mindlogger/WaveformMorpher/README.md

# WaveformMorpher
Morphing wavetable Synthesizer based on a Raspberry Pi.
Dependencies:
>= Portaudio v190600_20161030
https://github.com/grz0zrg/fbg
https://github.com/nlohmann/json
http://www.fftw.org/
https://github.com/thestk/rtmidi
