mindlogger/WaveformMorpher/hardware_design/WaveformMorpher_partlist.xlsx

Waveform Morpher v0.7
Qty | Parts | Value | Package | Device | Description | DESCRIPTION.1 | HEIGHT | MANUFACTURER_NAME | MANUFACTURER_PART_NUMBER | MF | MOUSER_PART_NUMBER | MOUSER_PRICE-STOCK | MPN | OC_FARNELL | OC_NEWARK | PROD_ID | RS_PART_NUMBER | RS_PRICE-STOCK | SF_SKU | Column1
3 | R8, R9, R26 | 1.0k | R0603 | R-US_R0603 | RESISTOR, American symbol
7 | R10, R12, R14, R17, R19, R21, R23 | 100k | R0603 | R-US_R0603 | RESISTOR, American symbol
5 | C1, C8, C10, C11, C12 | 100n | C0603 | C-USC0603 | CAPACITOR, American symbol
8 | R1, R2, R3, R4, R5, R6, R7, R11 | 10k | R0603 | R-US_R0603 | RESISTOR, American symbol
6 | P1, P2, P3, P4, P5, P6 | 10kB | 9MM_SNAP-IN_POT | 9MM_SNAP-IN_POT_ | 9mm vertical snap-in pot, Alpha / Panasonic style
1 | C5 | 10u | PANASONIC_B | CPOL-USB | POLARIZED CAPACITOR, American symbol
1 | C6 | 18p | C0603 | C-USC0603 | CAPACITOR, American symbol
3 | C2, C3, C4 | 1n | C0603 | C-USC0603 | CAPACITOR, American symbol
6 | R13, R15, R16, R18, R20, R22 | 24k9 | R0603 | R-US_R0603 | RESISTOR, American symbol
2 | R25, R27 | 47k | R0603 | R-US_R0603 | RESISTOR, American symbol
1 | R24 | 6.8k | R0603 | R-US_R0603 | RESISTOR, American symbol
1 | T1 | MMBT3904 | SOT23-BEC | MMBT3904LT1-NPN-SOT23-BEC | NPN Transistror
2 | D1, D2 | 1N5819HW | SOD3716X145N | 1N5819HW | 1.0A SURFACE MOUNT SCHOTTKY BARRIER RECTIFIER | 1.0A SURFACE MOUNT SCHOTTKY BARRIER RECTIFIER | 1.45mm | Diodes Inc. | 1N5819HW
1 | IC1 | MAX11615EEE+ | SOP64P602X175-16N | MAX11615EEE+ | IC,ADC,MAX11615EEE+ Maxim MAX11615EEE+, 12 bit Parallel ADC, 8-channel Differential Input, 16-Pin QSOP | IC,ADC,MAX11615EEE+ Maxim MAX11615EEE+, 12 bit Parallel ADC, 8-channel Differential Input, 16-Pin QSOP | 1.75mm | Maxim Integrated | MAX11615EEE+ |  | 700-MAX11615EEE | https://www.mouser.com/Search/Refine.aspx?Keyword=700-MAX11615EEE
1 | IC2 | MCP6004 | SO14 | TL074D | OP AMP
1 | IC3 | LM4041B12DBZ | DBZ_R-PDSO-G3 | LM4041B12DBZ | PRECISION MICROPOWER SHUNT VOLTAGE REFERENCE |  |  |  |  |  |  |  | LM4041B12IDBZR | 1575212 | 58K5882
1 | IC4 | LME49720MAX_NOPB | SOIC127P600X175-8N | LME49720MAX_NOPB | Dual High Performance, High Fidelity Audio Operational Amplifier | Dual High Performance, High Fidelity Audio Operational Amplifier | 1.75mm | Texas Instruments | LME49720MAX/NOPB |  | 926-LME49720MAX/NOPB | https://www.mouser.com/Search/Refine.aspx?Keyword=926-LME49720MAX%2FNOPB
7 | SW1, SW2, SW3, SW4, SW5, SW6, SW7 | MOMENTARY-SWITCH-SPST-PTH-6.0MM | TACTILE_SWITCH_PTH_6.0MM | MOMENTARY-SWITCH-SPST-PTH-6.0MM | Momentary Switch (Pushbutton) - SPST |  |  |  |  |  |  |  |  |  |  | SWCH-08441 |  |  | COM-00097
1 | RASPI |  | MA13-2 | MA13-2 | PIN HEADER
1 | JP1 | EURO_POWER_HEADERFAT_PADS | EURO_PWR_HEADER_FAT | EURO_POWER_HEADERFAT_PADS | Power Header
6 | J1, J2, J3, J4, J5, J6 | Jacks | WQP-PJ301M-12_JACK | WQP-PJ301M-12_JACK
7 | SC1, SC2, SC3, SC4, SC5, SC6, SC7 | Switchcaps
6 | PC1, PC2, PC3, PC4, PC5, PC6 | Potcaps
TH
SM
Other
