mindlogger/WaveformMorpher/hardware_design/pcb/WaveformMorpher.brd

## EAGLE design hardware_design/pcb/WaveformMorpher.brd (2020-03-28)

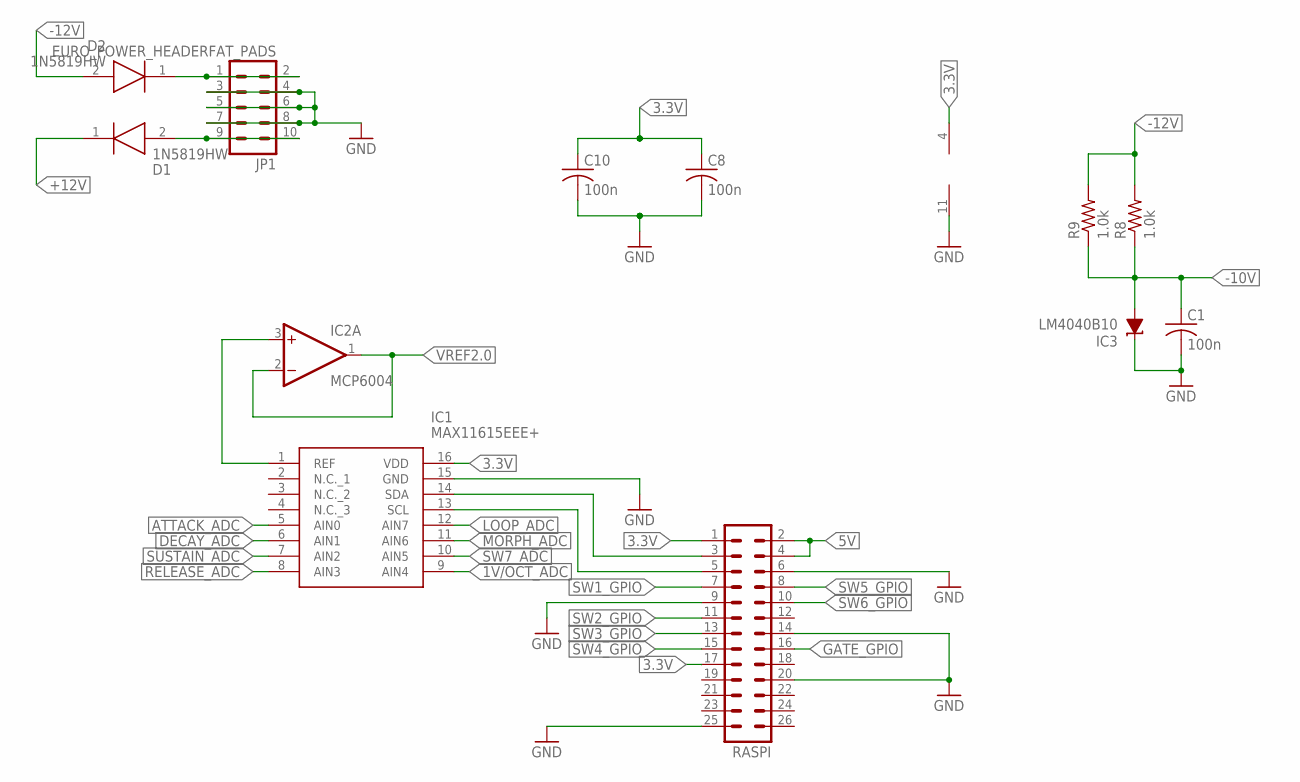
[picture p1: schematic WaveformMorpher.sch, sheet 1]

Parts:
C1, C8, C10: 100n; C0603
D1, D2: 1N5819HW; SOD3716X145N
IC1: MAX11615EEE+; SOP64P602X175-16N
IC2: MCP6004; SO14
IC3: LM4040B10; DBZ_R-PDSO-G3
JP1: EURO_POWER_HEADERFAT_PADS; EURO_PWR_HEADER_FAT
R8, R9: 1.0k; R0603
RASPI: MA13-2

Connections:
1V/OCT_ADC: IC1.9 (AIN4); also elsewhere on the board
3.3V: C8.1, C10.1, IC1.16 (VDD), IC2.4 (V+), RASPI.1, RASPI.17; also elsewhere on the board
5V: RASPI.2, RASPI.4; also elsewhere on the board
+12V: D1.1 (K); also elsewhere on the board
-10V: C1.1, IC3.2 (A), R8.1, R9.1; also elsewhere on the board
-12V: D2.2 (A), R8.2, R9.2; also elsewhere on the board
ATTACK_ADC: IC1.5 (AIN0); also elsewhere on the board
DECAY_ADC: IC1.6 (AIN1); also elsewhere on the board
GATE_GPIO: RASPI.16; also elsewhere on the board
GND: C1.2, C8.2, C10.2, IC1.15 (GND), IC2.11 (V-), IC3.1 (C), JP1.3, JP1.4, JP1.5, JP1.6, JP1.7, JP1.8, RASPI.6, RASPI.9, RASPI.14, RASPI.20, RASPI.25; also elsewhere on the board
LOOP_ADC: IC1.12 (AIN7); also elsewhere on the board
MORPH_ADC: IC1.11 (AIN6); also elsewhere on the board
unnamed: IC1.14 (SDA), RASPI.3
unnamed: IC1.1 (REF), IC2.3 (+IN)
unnamed: IC1.13 (SCL), RASPI.5
unnamed: D2.1 (K), JP1.1, JP1.2
unnamed: D1.2 (A), JP1.9, JP1.10
RELEASE_ADC: IC1.8 (AIN3); also elsewhere on the board
SUSTAIN_ADC: IC1.7 (AIN2); also elsewhere on the board
SW1_GPIO: RASPI.7; also elsewhere on the board
SW2_GPIO: RASPI.11; also elsewhere on the board
SW3_GPIO: RASPI.13; also elsewhere on the board
SW4_GPIO: RASPI.15; also elsewhere on the board
SW5_GPIO: RASPI.8; also elsewhere on the board
SW6_GPIO: RASPI.10; also elsewhere on the board
SW7_ADC: IC1.10 (AIN5); also elsewhere on the board
VREF2.0: IC2.1 (OUT), IC2.2 (-IN); also elsewhere on the board

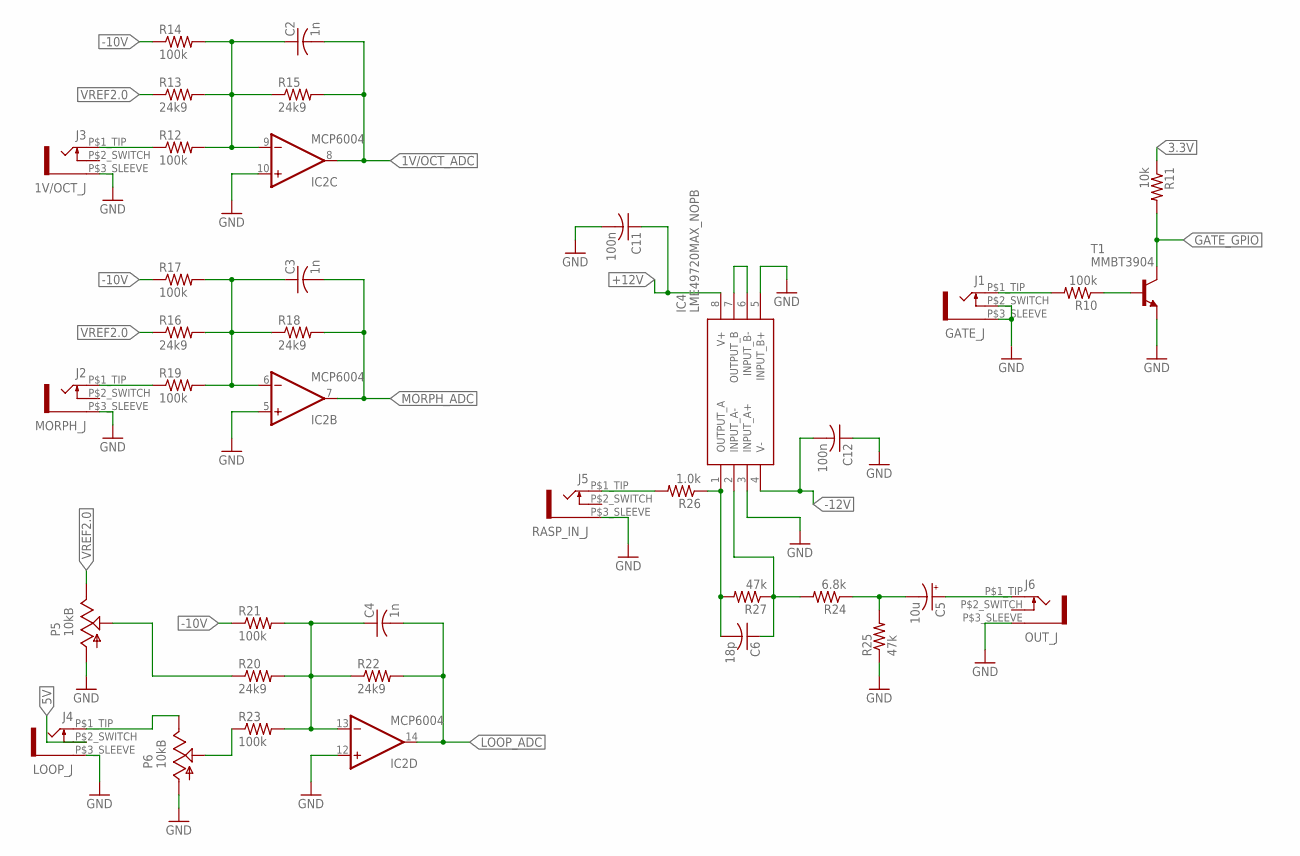
[picture p2: schematic WaveformMorpher.sch, sheet 2]

Parts:
C2, C3, C4: 1n; C0603
C5: 10u; PANASONIC_B
C6: 18p; C0603
C11, C12: 100n; C0603
IC2: MCP6004; SO14
IC4: LME49720MAX_NOPB; SOIC127P600X175-8N
J1: GATE_J; WQP-PJ301M-12_JACK
J2: MORPH_J; WQP-PJ301M-12_JACK
J3: 1V/OCT_J; WQP-PJ301M-12_JACK
J4: LOOP_J; WQP-PJ301M-12_JACK
J5: RASP_IN_J; WQP-PJ301M-12_JACK
J6: OUT_J; WQP-PJ301M-12_JACK
P5, P6: 10kB; 9MM_SNAP-IN_POT
R10, R12, R14, R17, R19, R21, R23: 100k; R0603
R11: 10k; R0603
R13, R15, R16, R18, R20, R22: 24k9; R0603
R24: 6.8k; R0603
R25, R27: 47k; R0603
R26: 1.0k; R0603
T1: MMBT3904; SOT23-BEC

Connections:
1V/OCT_ADC: C2.2, IC2.8 (OUT), R15.2; also elsewhere on the board
3.3V: R11.1; also elsewhere on the board
5V: J4.P$2_SWITCH (3); also elsewhere on the board
+12V: C11.1, IC4.8 (V+); also elsewhere on the board
-10V: R14.1, R17.1, R21.1; also elsewhere on the board
-12V: C12.2, IC4.4 (V-); also elsewhere on the board
GATE_GPIO: R11.2, T1.C; also elsewhere on the board
GND: C11.2, C12.1, IC2.5 (+IN), IC2.10 (+IN), IC2.12 (+IN), IC4.3 (INPUT_A+), IC4.5 (INPUT_B+), J1.P$2_SWITCH (3), J1.P$3_SLEEVE (1), J2.P$3_SLEEVE (1), J3.P$3_SLEEVE (1), J4.P$3_SLEEVE (1), J5.P$3_SLEEVE (1), J6.P$3_SLEEVE (1), P5.1 (A), P6.1 (A), R25.1, T1.E; also elsewhere on the board
LOOP_ADC: C4.2, IC2.14 (OUT), R22.2; also elsewhere on the board
MORPH_ADC: C3.2, IC2.7 (OUT), R18.2; also elsewhere on the board
unnamed: J1.P$1_TIP (2), R10.2
unnamed: R10.1, T1.B
unnamed: J2.P$1_TIP (2), R19.1
unnamed: C2.1, IC2.9 (-IN), R12.2, R13.2, R14.2, R15.1
unnamed: C3.1, IC2.6 (-IN), R16.2, R17.2, R18.1, R19.2
unnamed: J3.P$1_TIP (2), R12.1
unnamed: C4.1, IC2.13 (-IN), R20.2, R21.2, R22.1, R23.2
unnamed: J4.P$1_TIP (2), P6.3 (E)
unnamed: IC4.6 (INPUT_B-), IC4.7 (OUTPUT_B)
unnamed: C6.2, IC4.1 (OUTPUT_A), R26.1, R27.2
unnamed: J5.P$1_TIP (2), R26.2
unnamed: C5.+, J6.P$1_TIP (2)
unnamed: C5.-, R24.1, R25.2
unnamed: P5.2 (S), R20.1
unnamed: C6.1, IC4.2 (INPUT_A-), R24.2, R27.1
unnamed: P6.2 (S), R23.1
VREF2.0: P5.3 (E), R13.1, R16.1; also elsewhere on the board

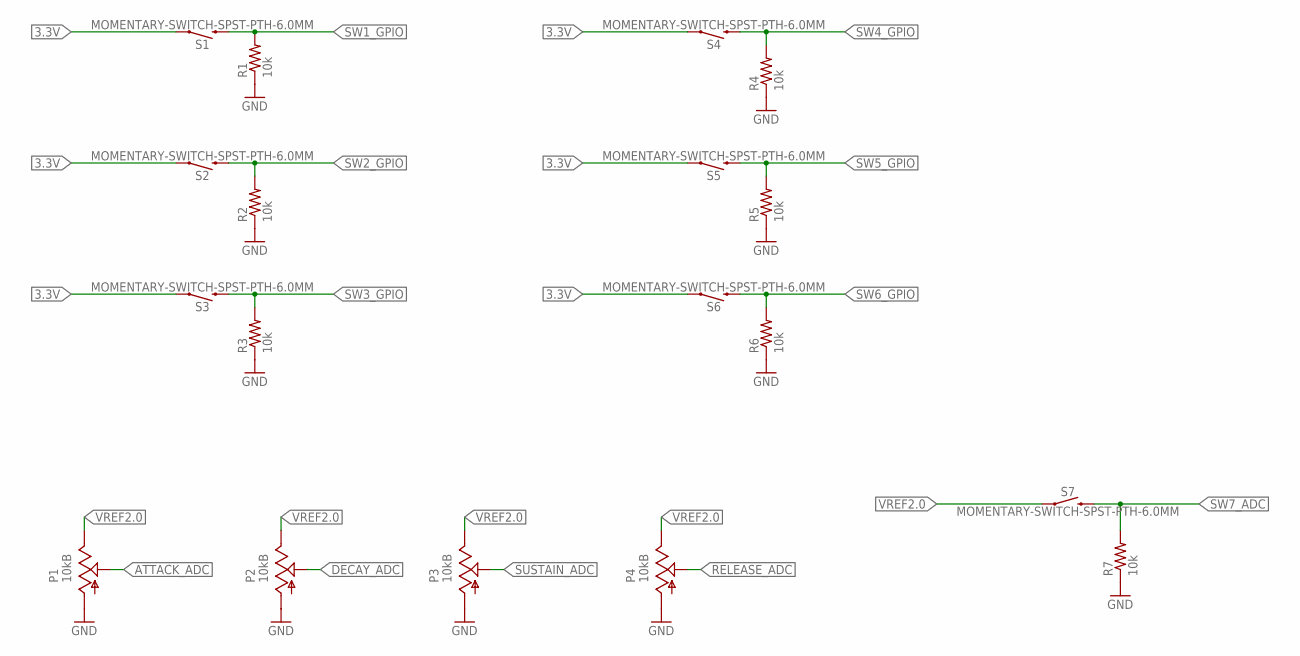
[picture p3: schematic WaveformMorpher.sch, sheet 3]

Parts:
P1, P2, P3, P4: 10kB; 9MM_SNAP-IN_POT
R1, R2, R3, R4, R5, R6, R7: 10k; R0603
S1, S2, S3, S4, S5, S6, S7: MOMENTARY-SWITCH-SPST-PTH-6.0MM; TACTILE_SWITCH_PTH_6.0MM

Connections:
3.3V: S1.1, S2.1, S3.1, S4.1, S5.1, S6.1; also elsewhere on the board
ATTACK_ADC: P1.2 (S); also elsewhere on the board
DECAY_ADC: P2.2 (S); also elsewhere on the board
GND: P1.1 (A), P2.1 (A), P3.1 (A), P4.1 (A), R1.1, R2.1, R3.1, R4.1, R5.1, R6.1, R7.1; also elsewhere on the board
RELEASE_ADC: P4.2 (S); also elsewhere on the board
SUSTAIN_ADC: P3.2 (S); also elsewhere on the board
SW1_GPIO: R1.2, S1.3 (2); also elsewhere on the board
SW2_GPIO: R2.2, S2.3 (2); also elsewhere on the board
SW3_GPIO: R3.2, S3.3 (2); also elsewhere on the board
SW4_GPIO: R4.2, S4.3 (2); also elsewhere on the board
SW5_GPIO: R5.2, S5.3 (2); also elsewhere on the board
SW6_GPIO: R6.2, S6.3 (2); also elsewhere on the board
SW7_ADC: R7.2, S7.3 (2); also elsewhere on the board
VREF2.0: P1.3 (E), P2.3 (E), P3.3 (E), P4.3 (E), S7.1; also elsewhere on the board

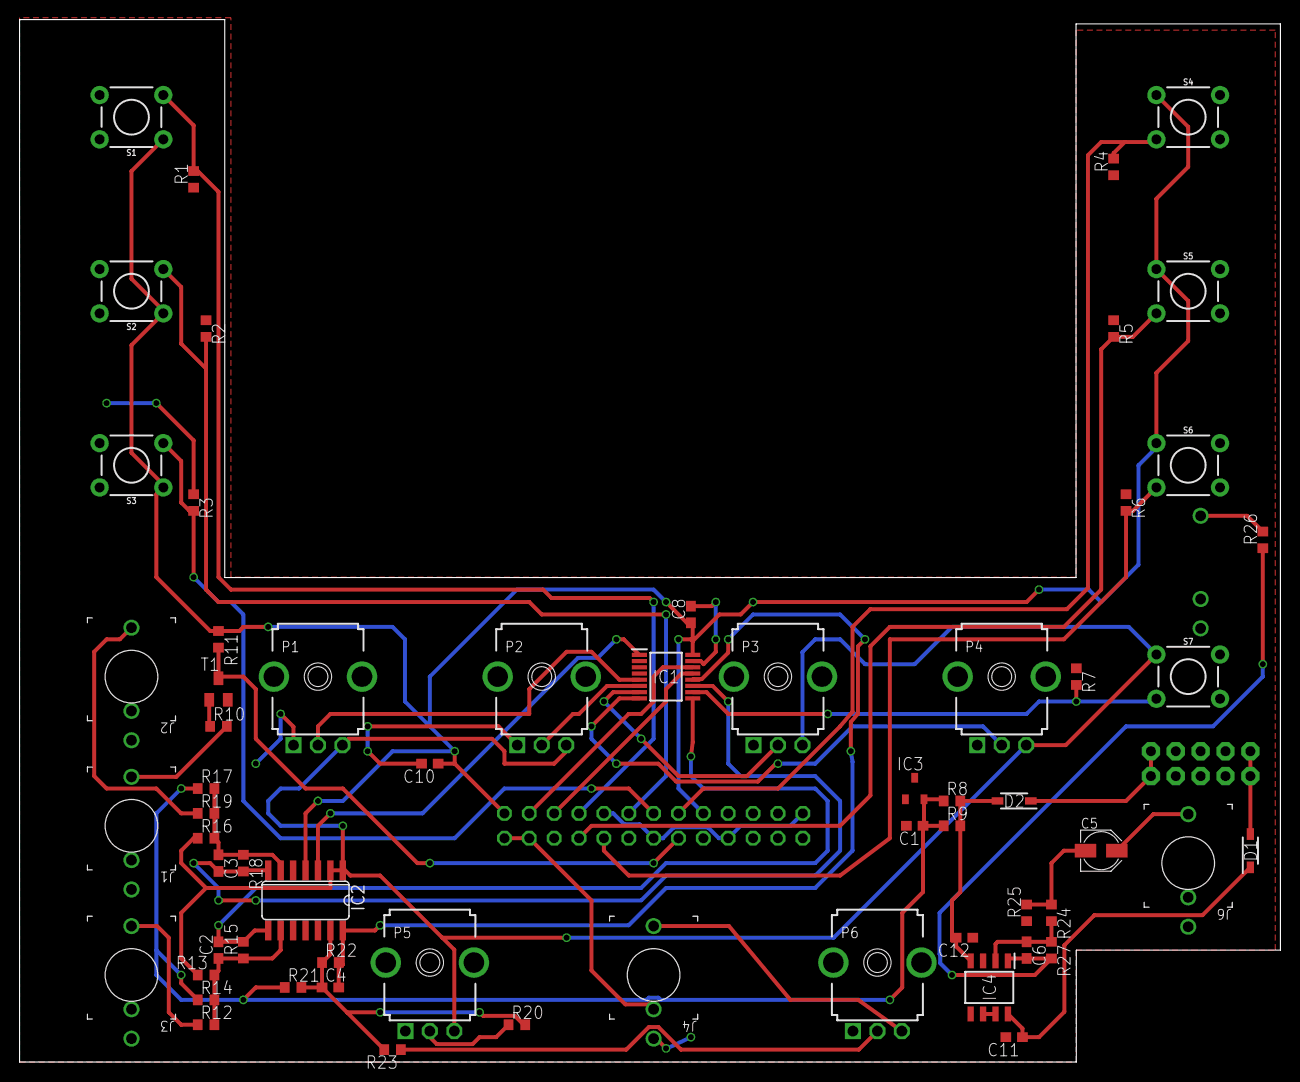
[picture p4: board WaveformMorpher.brd from above]

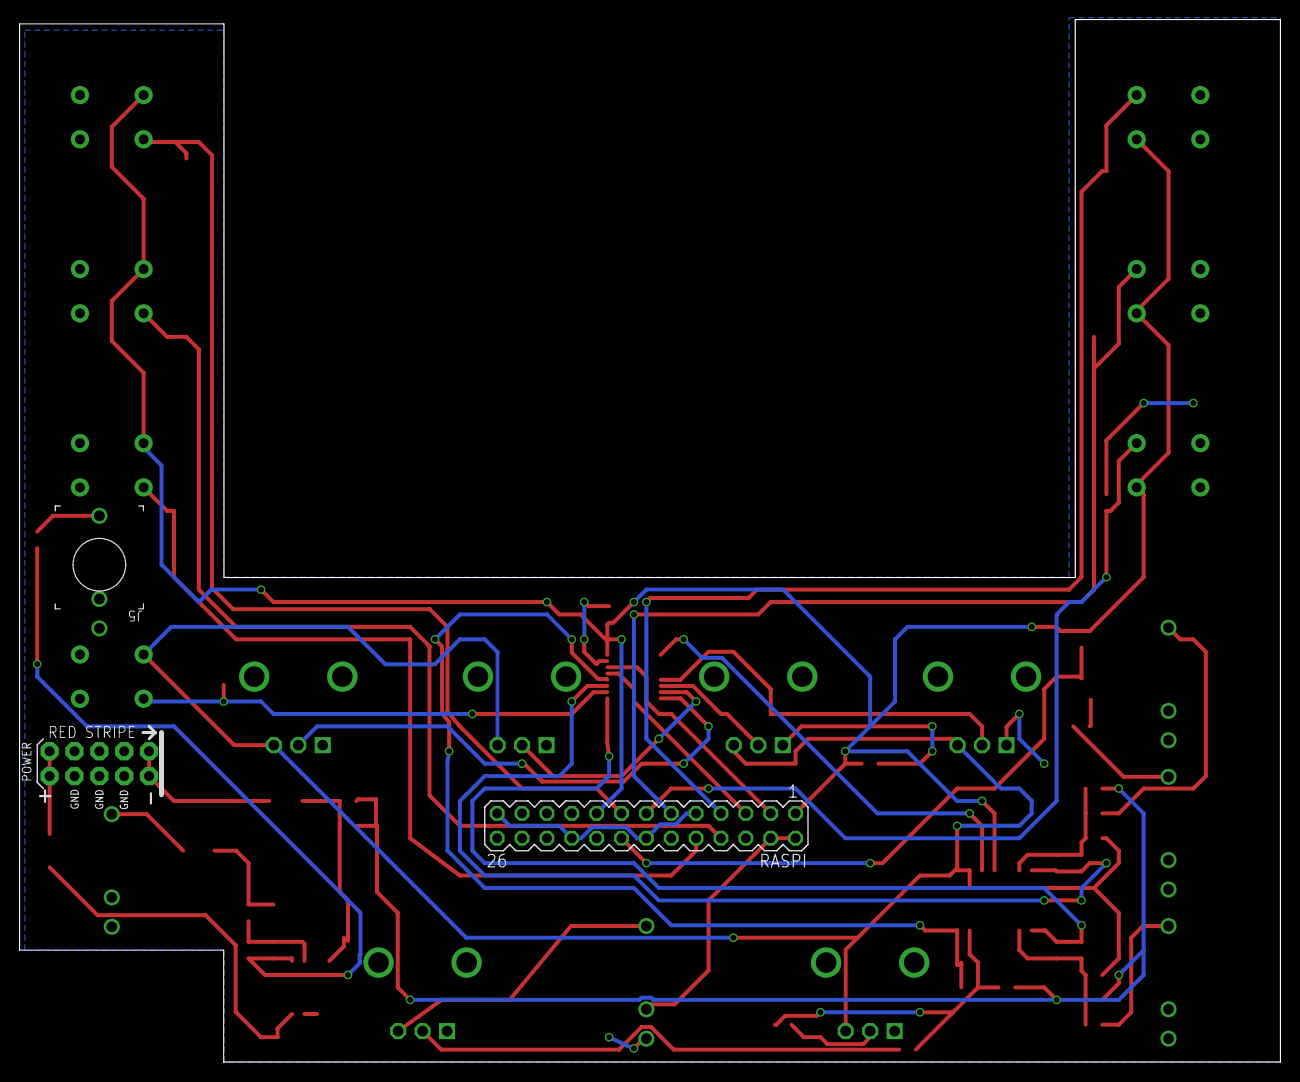
[picture p5: board WaveformMorpher.brd from below]

Board: 2 copper layers, 128.8 x 106.5 mm, 65 parts (3 on the bottom side), 43 nets.
