mindlogger/WaveformMorpher/src/MidiHandling.cpp

#include "MidiHandling.hpp"
#include "WaveOsc.hpp"
#include "GlobalDefinitions.hpp"

#include <iostream>
#include <cstdlib>
#include <algorithm>
#include <vector>

#include "RtMidi.h"

RtMidiIn *midiin;

double MidiNote2Freq[120] = {16.35,
17.32,
18.35,
19.45,
20.60,
21.83,
23.12,
24.50,
25.96,
27.50,
29.14,
30.87,
32.70,
34.65,
36.71,
38.89,
41.20,
43.65,
46.25,
49.00,
51.91,
55.00,
58.27,
61.74,
65.41,
69.30,
73.42,
77.78,
82.41,
87.31,
92.50,
98.00,
103.83,
110.00,
116.54,
123.47,
130.81,
138.59,
146.83,
155.56,
164.81,
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
};

std::vector<unsigned char> noteHistory;

void midiCallback( double deltatime, std::vector< unsigned char > *message, void *userData )
{
    unsigned int nBytes = message->size();
    for ( unsigned int i=0; i<nBytes; i++ )
    {
        switch ((int)message->at(i))
        {
        case 144:{
                    i++; //GET NOTE DATA

                    double f = MidiNote2Freq[(int)message->at(i)];
                    noteHistory.push_back(message->at(i));
                    setfreq(f);
                    WEnv->gate(true);
                    AEnv->gate(true);

                    i++; //SKIP VELOCITY DATA
                }
        break;
        case 128:{
                    i++;//GET NOTE DATA

                    std::vector<unsigned char>::iterator releasedNoteIterator = std::find(noteHistory.begin(), noteHistory.end(), (int) message->at(i));
                    for(int i = 0; i < noteHistory.size();i++)
                    {
                        if(*releasedNoteIterator == (unsigned char) noteHistory[i])
                        {
                            noteHistory.erase(releasedNoteIterator); //ERASE THE RELEASED NOTE
                        }
                    }

                    if(noteHistory.empty())
                    {
                        WEnv->gate(false); //TURN GATE OFF IF NO NOTES LEFT
                        AEnv->gate(false);
                    }
                    else
                    {
                        double f = MidiNote2Freq[noteHistory.back()]; //SWITCH TO NEW NOTE
                        setfreq(f);
                    }

                    i++;//SKIP VELOCITY DATA
                }
        break;
        default:
        break;
        }
    }
}

void allMidiNotesOff()
{
    WEnv->gate(false); //TURN GATE OFF
    AEnv->gate(false); //TURN GATE OFF
    noteHistory.clear();
}

void initMidi()
{
    midiin = new RtMidiIn();
    // Check available ports.
    unsigned int nPorts = midiin->getPortCount();
    if ( nPorts < 2 )
    {
        std::cout << "No ports available!\n";
        endMidi();
    }
    else
    {
        midiin->openPort( 1 );
        // Set our callback function.  This should be done immediately after
        // opening the port to avoid having incoming messages written to the
        // queue.
        midiin->setCallback( &midiCallback );
        // Don't ignore sysex, timing, or active sensing messages.
        midiin->ignoreTypes( false, false, false );
        std::cout << "Midi setup done.\n";
    }
}

void endMidi()
{
    delete midiin;
}
