mindlogger/WaveformMorpher/src/UIRenderer.hpp

// UIRenderer.hpp
#ifndef UIRENDERER_H
#define UIRENDERER_H
void insertCurrentTableName();
void renderEditView();
void renderPatchSettings();
void renderGlobalSettings();
void renderFilterMode();
void renderBlurMode();
void renderAttenuateMode();
void renderLoad();
void renderStore();
void renderInsertWave();
void renderUserInsertWave();
void renderHiddenMode();
#endif
