mindlogger/WaveformMorpher/src/WaveGenerator.hpp

//WaveGenerator.h
#ifndef WAVEGENERATOR_H
#define WAVEGENERATOR_H
void genSin(double* waveTable);
void genSaw(double* waveTable);
void genSqr(double* waveTable);
void genSil(double* waveTable);
#endif
