mindlogger/WaveformMorpher/(commit log)

2020-01-31 wavetable stable AND timer initial setup
2020-02-02 table2screen fixed AND DFT improvements AND terminal control
    [AudioOut.cpp, FourierTransformer.cpp, FourierTransformer.hpp, Touchscreen.cpp, WaveOsc.cpp, WaveOsc.hpp, main.cpp]
2020-02-05 basic rounding implemented AND continousScreen fixed
    [FourierTransformer.cpp, Touchscreen.cpp, WaveGenerator.cpp, main.cpp]
2020-02-05 touchscreen and framebuffer fixes at cost of audio lags
    [Touchscreen.cpp, Touchscreen.hpp, main.cpp]
2020-02-13 BROKEN BUILD BUT FIRST REAL IFFT WITH SPEC EDIT POSSIBLE
    [FourierTransformer.cpp, FourierTransformer.hpp, Touchscreen.cpp, Touchscreen.hpp, main.cpp]
2020-03-11 setup hardware stuff
    [WaveformMorpher.sch, WaveformMorpher_partlist.xlsx]
2020-03-18 Board added
    [WaveformMorpher.brd, WaveformMorpher.sch]
2020-03-18 Board first placements
    [WaveformMorpher.brd, WaveformMorpher.sch]
2020-03-20 adding vias
    [WaveformMorpher.brd, WaveformMorpher.sch]
2020-03-23 finishing up the board
    [WaveformMorpher.brd, WaveformMorpher.sch]
2020-03-24 hardware v0.7
    [WaveformMorpher.brd, WaveformMorpher.sch]
2020-03-28 partlist and bugfixes
    [WaveformMorpher.brd, WaveformMorpher.sch, WaveformMorpher_partlist.xlsx]
2020-04-04 listclear timer setup
2020-04-20 removed bin and obj files AND envelope and dyn mode fixes
    [ADSR.cpp, FbGraphics.cpp, FourierTransformer.cpp, GlobalDefinitions.hpp, Touchscreen.cpp, WaveOsc.cpp, main.cpp]
2020-04-22 partlist excel bugfix
    [WaveformMorpher_partlist.xlsx]
2020-04-26 ADC basic setup
2020-04-27 audio looping setup AND small fixes
    [FbGraphics.cpp, FourierTransformer.cpp, GlobalDefinitions.hpp, TimerEvent.cpp, UI.cpp, WaveOsc.cpp, main.cpp]
2022-08-20 fixed dynamic mode and added marker
    [ButtonActions.cpp, ButtonActions.hpp, FbGraphics.cpp, UIRenderer.cpp, UIRenderer.hpp]
2022-08-21 wave insertion page
2022-08-21 added color + fixed bunch of screen alignment
    [ButtonActions.cpp, FbGraphics.cpp, FbGraphics.hpp, GlobalDefinitions.hpp, GlobalPreset.cpp, GlobalPreset.hpp, UIRenderer.cpp]
2022-08-23 added filter modes
2022-08-24 fixed multiple sources of clipping
    [AudioOut.cpp, Blur.cpp, FourierTransformer.cpp, WaveOsc.cpp]
2022-08-24 fixing audio shit work in progress
    [ADSR.hpp, AudioOut.cpp, FbGraphics.cpp, GlobalDefinitions.hpp, MidiHandling.cpp, UI.cpp, WaveGenerator.cpp, WaveOsc.cpp]
2022-08-24 added reboot but commented it out
    [ButtonActions.cpp, ButtonActions.hpp, FbGraphics.cpp, UIRenderer.cpp]
